amarellapudi/EEG-Project/Bill Of Materials.xlsx

Part | Description | Quantity | Price/Unit for 100 Quanitity
1uF | Capacitor | 2 | 0.10892 | 18 | 1.96056
10uF | Capacitor | 16 |  |  | 0
1 | Resistor | 1 | 0.00577 | 22 | 0.12694
330 | Resistor | 2 |  |  | 0
1k | Resistor | 4 |  |  | 0
3k | Resistor | 4 |  |  | 0
10k | Resistor | 2 |  |  | 0
150k | Resistor | 4 |  |  | 0
1Meg | Resistor | 2 |  |  | 0
3.3Meg | Resistor | 1 |  |  | 0
10Meg | Resistor | 2 |  |  | 0
OPA347PA | MicroPower, Operational Amplifier | 7 | 0.438 | 7 | 3.066
INA2126P | Micropower Instrumentation Amplifier | 1 | 3.60753 | 1 | 3.60753
SRDA3.3-4DR2G | ESD Protection | 1 | 0.803 | 1 | 0.803
CR123A | CR123A Battery | 1 | 2.49 | 1 | 2.49
BCR123A | Battery Housing | 1 | 1.2317 | 1 | 1.2317
TE Connectivity 1-1337543-0 | BNC Connector | 2 | 1.575 | 2 | 3.15
36619 1.5mm Touchproof EEG Connectors | PCB Electrode Jack | 4 | 1.86 | 4 | 7.44
5cm x 10cm PCB | Estimate from Fusion PCB | 100 | 1.1647 | 1 | 1.1647
 |  | 25.04043
