amarellapudi/EEG-Project/(list of files, drawings)

Other design files:
Device Libraries/0.pcblib
Device Libraries/op-amps/opa348_pspice_aio/OPA348.DSN
Device Libraries/op-amps/opa348_pspice_aio/OPA348.OLB
Device Libraries/op-amps/opa348_pspice_aio/OPA348.opj
EEG/EEG.PrjPcb
EEG/EEG.SchDoc
