amarellapudi/EEG-Project/(commit log)

2016-10-20 Circuitry and Presentation
    [0.pcblib, Bill Of Materials.xlsx, EEG.PrjPcb, EEG.SchDoc, OPA348.DSN, OPA348.OLB, OPA348.opj]
2016-10-24 Updated Schematics
2016-10-24 Schematic Updates
    [EEG.PrjPcb, EEG.sdf]
2016-10-24 Schematic Fixes
    [EEG.PrjPcb, EEG.SchDoc, EEG.sdf]
